khaita03/RANSAC_ROBOT/back_pcb.png

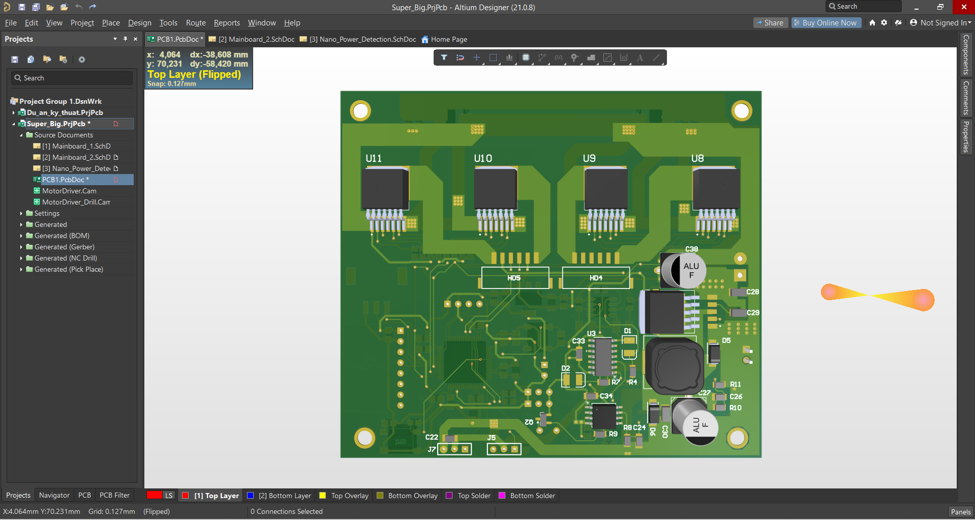
back_pcb.png
