khaita03/RANSAC_ROBOT/config_mcu.jpg

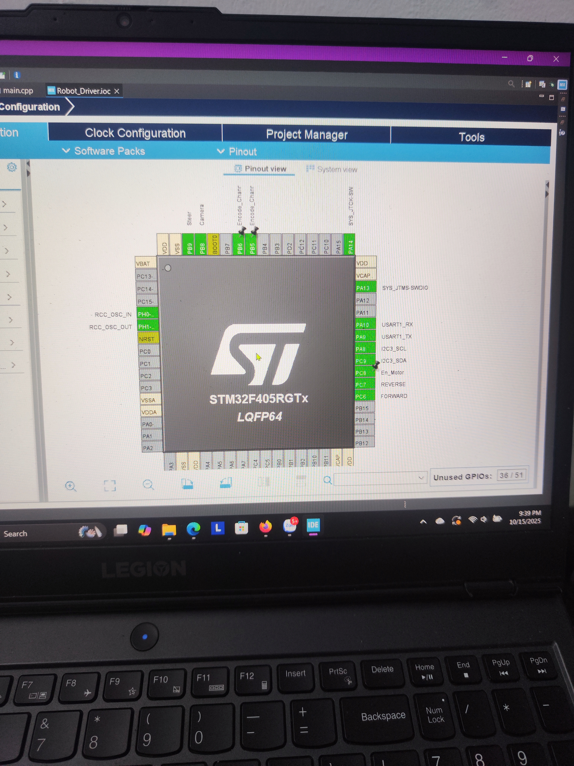
config_mcu.jpg
