khaita03/RANSAC_ROBOT/front_pcb.png

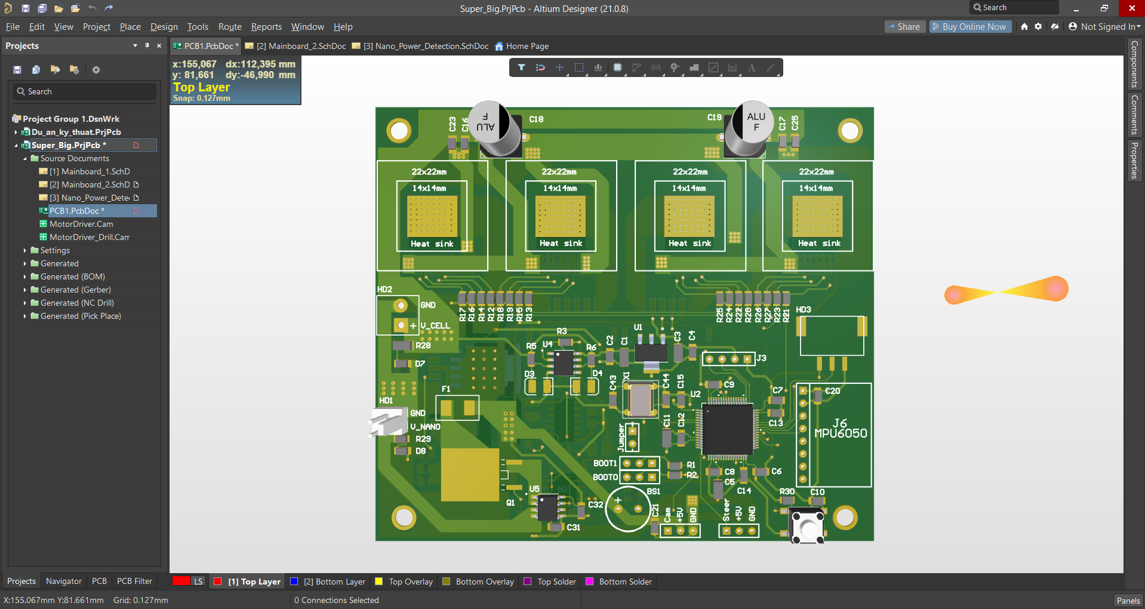
front_pcb.png
