khaita03/RANSAC_ROBOT/mainboard_1 schematic.png

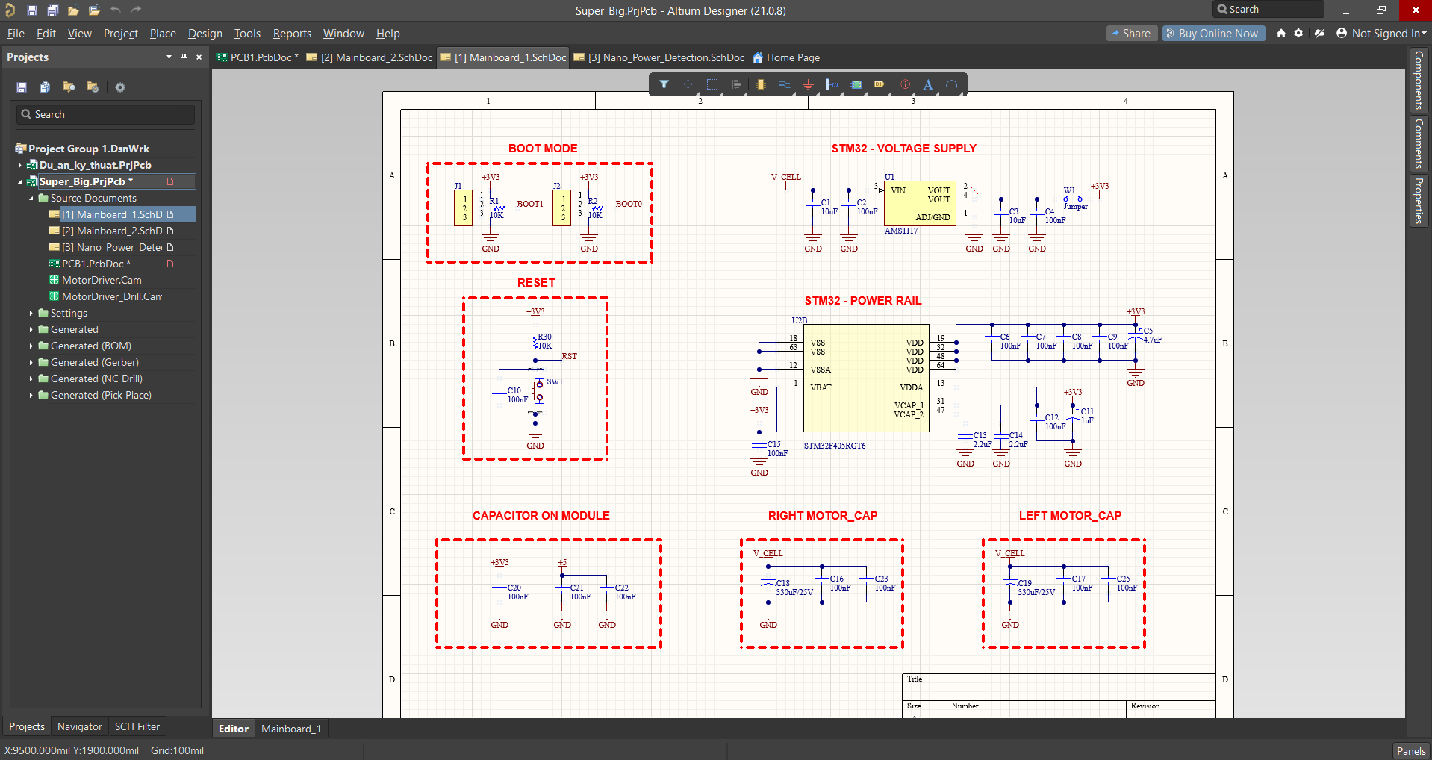
mainboard_1 schematic.png
