khaita03/RANSAC_ROBOT/mainboard_2 schematic.png

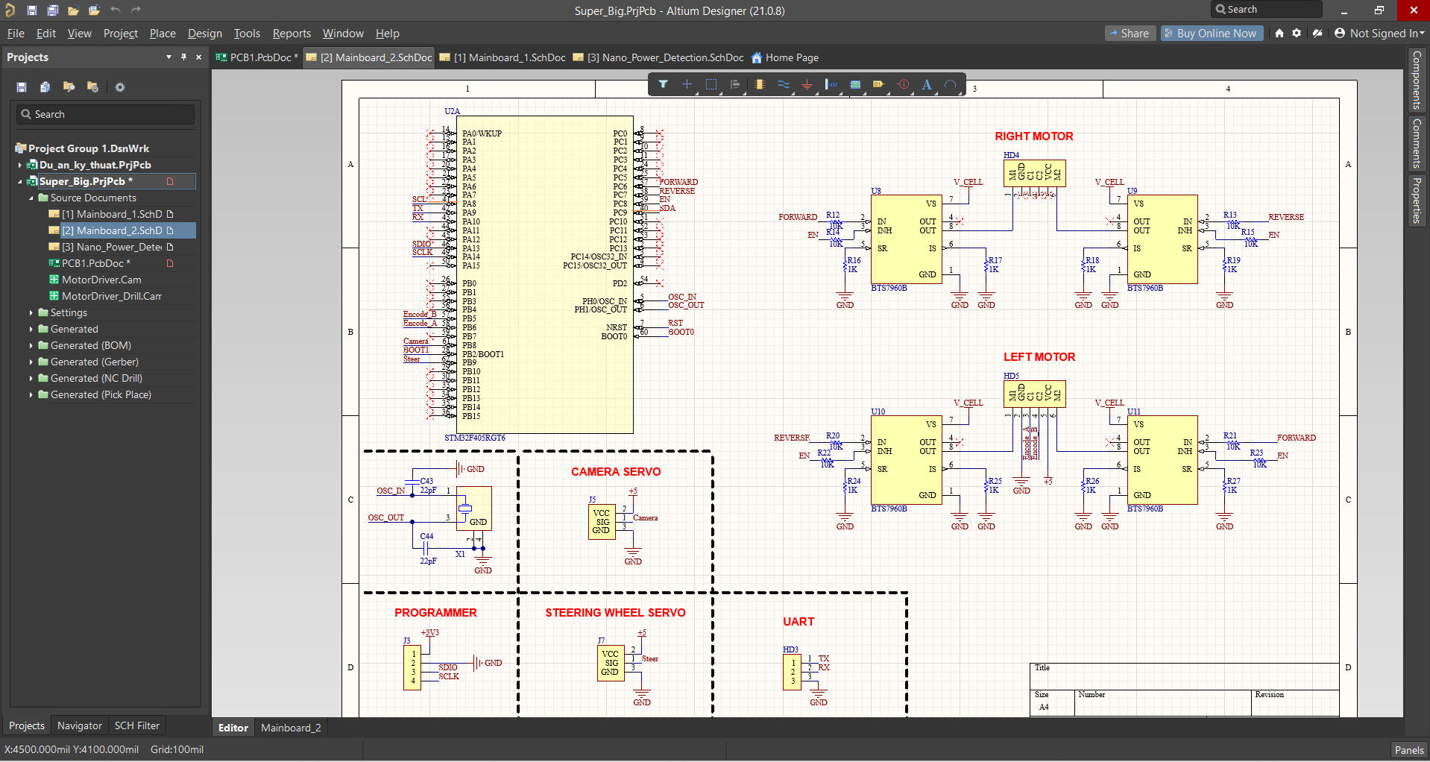
mainboard_2 schematic.png
