khaita03/RANSAC_ROBOT/power_detect schematic.png

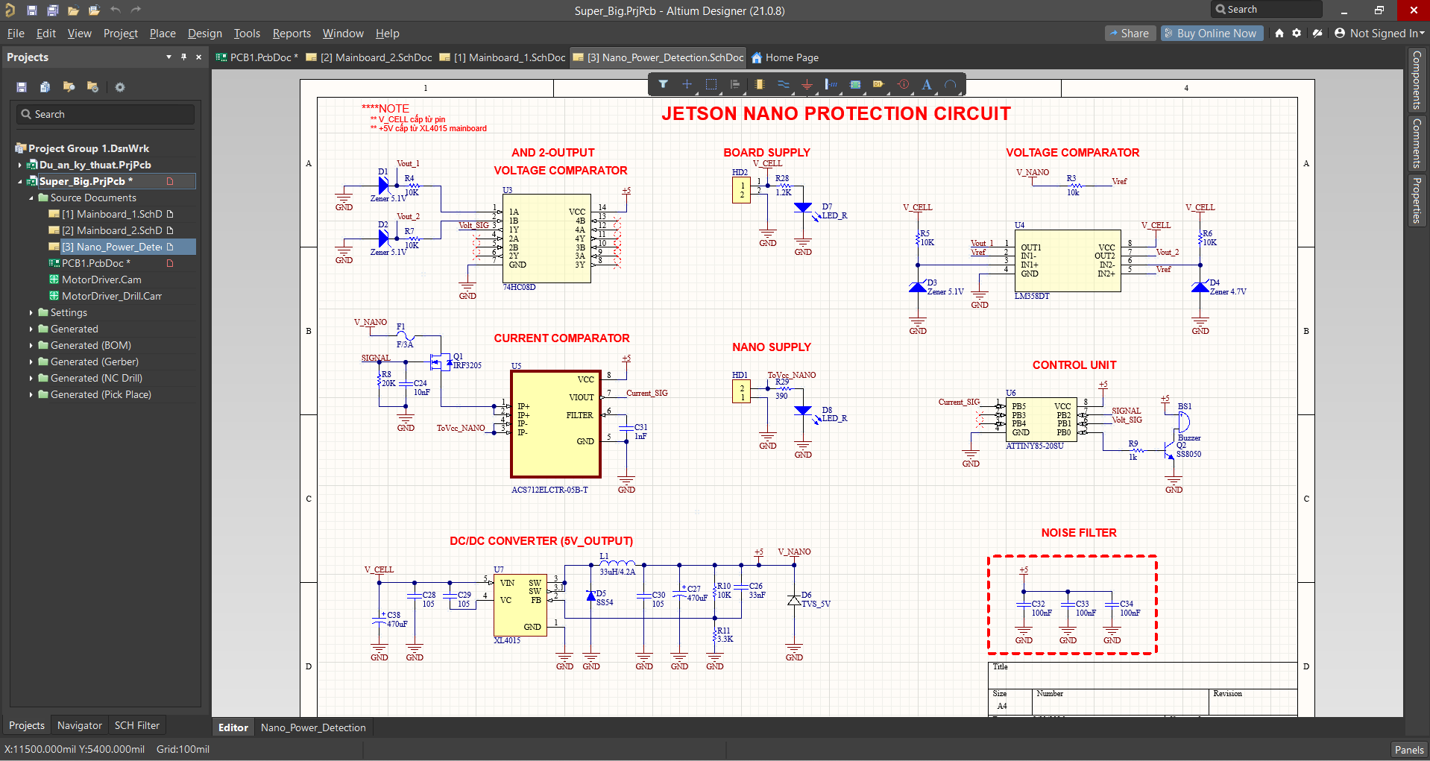
power_detect schematic.png
