khaita03/RANSAC_ROBOT/PCB/Driver/Project Outputs for Super_Big/BOM/Bill of Materials-Super_Big.xlsx

Comment | Description | Designator | Footprint | LibRef | Quantity
1nF | Capacitor | C31 | 6-0805_M | Cap | 1
1uF | Polarized Capacitor (Radial) | C11 | C1206 | Cap Pol1 | 1
1.2K | Resistor | R28 | C1206 | Res1 | 1
2_pin connector |  | HD2 | 2_PIN POWER 3.96 | 2_pin connector | 1
3_pin conn |  | HD3 | 3-pin XHB_2.54 | 3_pin conn | 1
3.3K | Resistor | R11 | 6-0805_N | Res1 | 1
4_pin connector |  | J3 | 4_PIN 2.54mm | 4_pin connector | 1
8_pin IMU Connector |  | J6 | 8_PIN IMU CONNECTOR - duplicate | 8_pin IMU Connector | 1
10nF | Capacitor | C24 | 6-0805_M | Cap | 1
20K | Resistor | R8 | 6-0805_N | Res1 | 1
33nF | Capacitor | C26 | 6-0805_M | Cap | 1
33uH/4.2A | Inductor | L1 | IND_CDRH127/LDNP-470MC_SUM | Inductor | 1
74HC08D |  | U3 | SO14_SOT108-1_NEX | 74HC08D | 1
390 | Resistor | R29 | 6-0805_N | Res1 | 1
ACS712ELCTR-05B-T | Current Sensor 5A 1 Channel Hall Effect, Open Loop Bidirectional 8-SOIC (0.154, 3.90mm Width) | U5 | SOIC127P600X175-8N | ACS712ELCTR-05B-T | 1
AMS1117 | 1A LOW DROPOUT VOLTAGE REGULATOR SOT-223 | U1 | SOT229P700X180-4N | AMS1117 | 1
ATTINY85-20SU |  | U6 | 8S2_ATM | ATTINY85-20SU | 1
Buzzer |  | BS1 | Buzzer | Buzzer | 1
Cap Pol1 | Polarized Capacitor (Radial) | C5 | C1206 | Cap Pol1 | 1
F/3A |  | F1 | FUSE (6.1 x 2.69 x 2.69mm) - duplicate | Fuse | 1
Header2 | Header IDC, 2 x 1 Pin Vertical 2.54mm Pitch (Non-Boxed, Male) | HD1 | HDR2 | Header2 | 1
IRFZ44 |  | Q1 | TO-263 | IRFZ44 | 1
Jumper |  | W1 | Jumper | Jumper | 1
LM358DT |  | U4 | SOIC127P600X175-8N | LM358DT | 1
SS54 | Diode Schottky 40 V 5A Surface Mount DO-214AC (SMA) | D5 | DIOT_M5_025X220N | SS54-HF | 1
SS8050 | NPN General Purpose Amplifier | Q2 | SOT23_M | SS8050 | 1
STM32F405RGT6 | High-performance foundation line, Arm Cortex-M4 core with DSP and FPU, 1 Mbyte of Flash memory, 168 MHz CPU, ART Accelerator | U2 | LQFP64-10x10mm | STM32F405RGT6 | 1
SW | Switch button 4 pin | SW1 | SW2-SMD | SW4 | 1
TVS_5V |  | D6 | DIOT_M5_025X220N | TVS_5V | 1
XL4015 | 5A 180KHz 36V Buck DC to DC Converter | U7 | CONV_XL4015 | XL4015 | 1
XT4 | Crystal, 16 MHz, -30 to 85 degC, 3.2 x 2.5 x 0.9 mm SMD | X1 | XT4-SMD | XT4 | 1
Zener 4.7V | Zener Diode | D4 | 3.5X2.8X1.9 | D Zener | 1
2.2uF | Capacitor | C13, C14 | 6-0805_M | Cap | 2
3_pin connector | Boot using for stm32 | J1, J2 | 3_PIN SERVO CONNECTOR | 3_pin connector | 2
3_pin steering wheel |  | J5, J7 | 3_PIN SERVO CONNECTOR | 3_pin steering wheel | 2
6-pin connnector (Encoder DC motor 2mm) |  | HD4, HD5 | 6_PIN MOTOR | 6-pin connnector (Encoder DC motor 2.54mm) | 2
10uF | Capacitor | C1, C3 | C1206 | Cap | 2
22pF | Capacitor | C43, C44 | 6-0805_M | Cap | 2
330uF/25V | Capacitor (Semiconductor SIM Model) | C18, C19 | CAP-ALU-SMD-F | CN-ALU-DIP | 2
470uF | Polarized Capacitor (Surface Mount) | C27, C38 | CAP-ALU-SMD-F | Cap Pol3 | 2
LED_R | Typical RED GaAs LED | D7, D8 | 6-0805_M | LED1 | 2
105 | Capacitor | C28, C29, C30 | C1206 | Cap | 3
Zener 5.1V | Zener Diode | D1, D2, D3 | 3.5X2.8X1.9 | D Zener | 3
BTS7960B | Half Bridge Driver DC Motors, General Purpose DMOS PG-TO263-7-1 | U8, U9, U10, U11 | DPAK127P1490X440-8N | BTS7960B | 4
1k | Resistor | R9, R16, R17, R18, R19, R24, R25, R26, R27 | 6-0805_N | Res1 | 9
10K | Resistor | R1, R2, R3, R4, R5, R6, R7, R10, R12, R13, R14, R15, R20, R21, R22, R23, R30 | 6-0805_N | Res1 | 17
100nF | Capacitor | C2, C4, C6, C7, C8, C9, C10, C12, C15, C16, C17, C20, C21, C22, C23, C25, C32, C33, C34 | 6-0805_M | Cap | 19
