khaita03/RANSAC_ROBOT/row_test.jpg

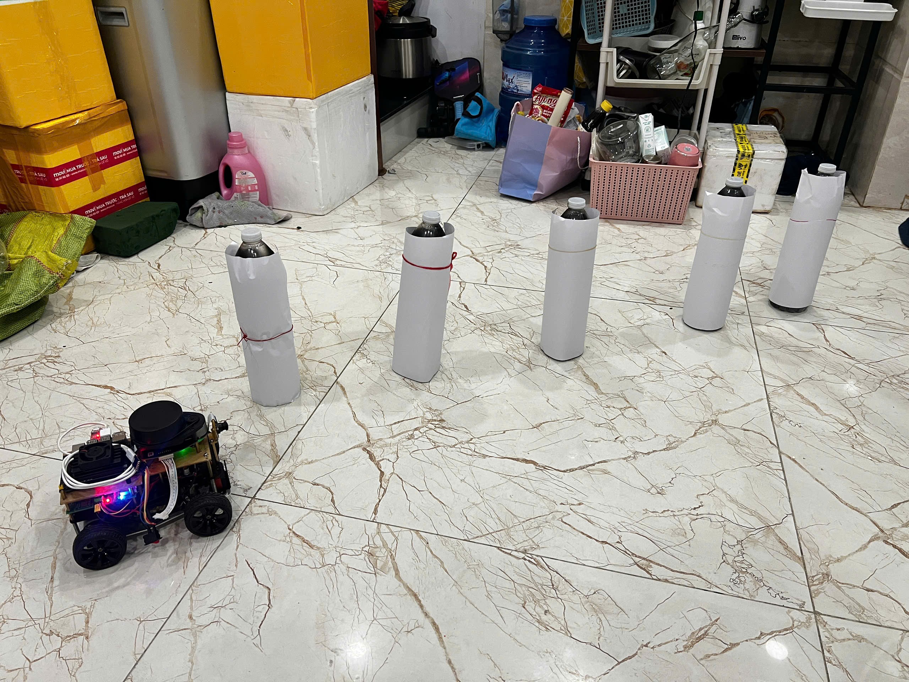
row_test.jpg
