khaita03/RANSAC_ROBOT/PCB/Driver/Mainboard_1.pdf

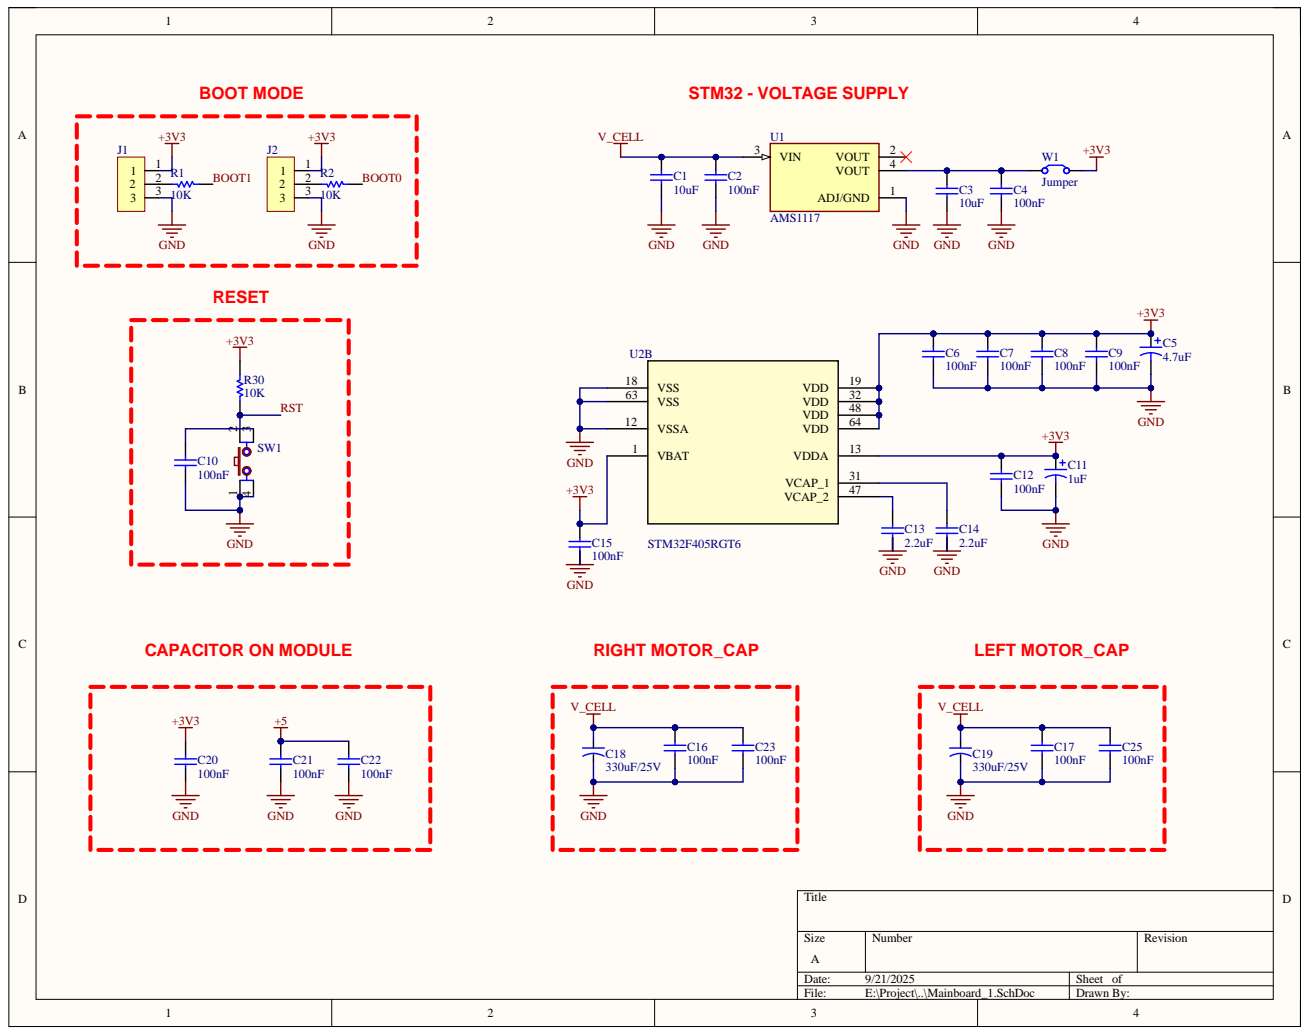
[picture p12: page 1]
