khaita03/RANSAC_ROBOT/PCB/Driver/Mainboard_2.pdf

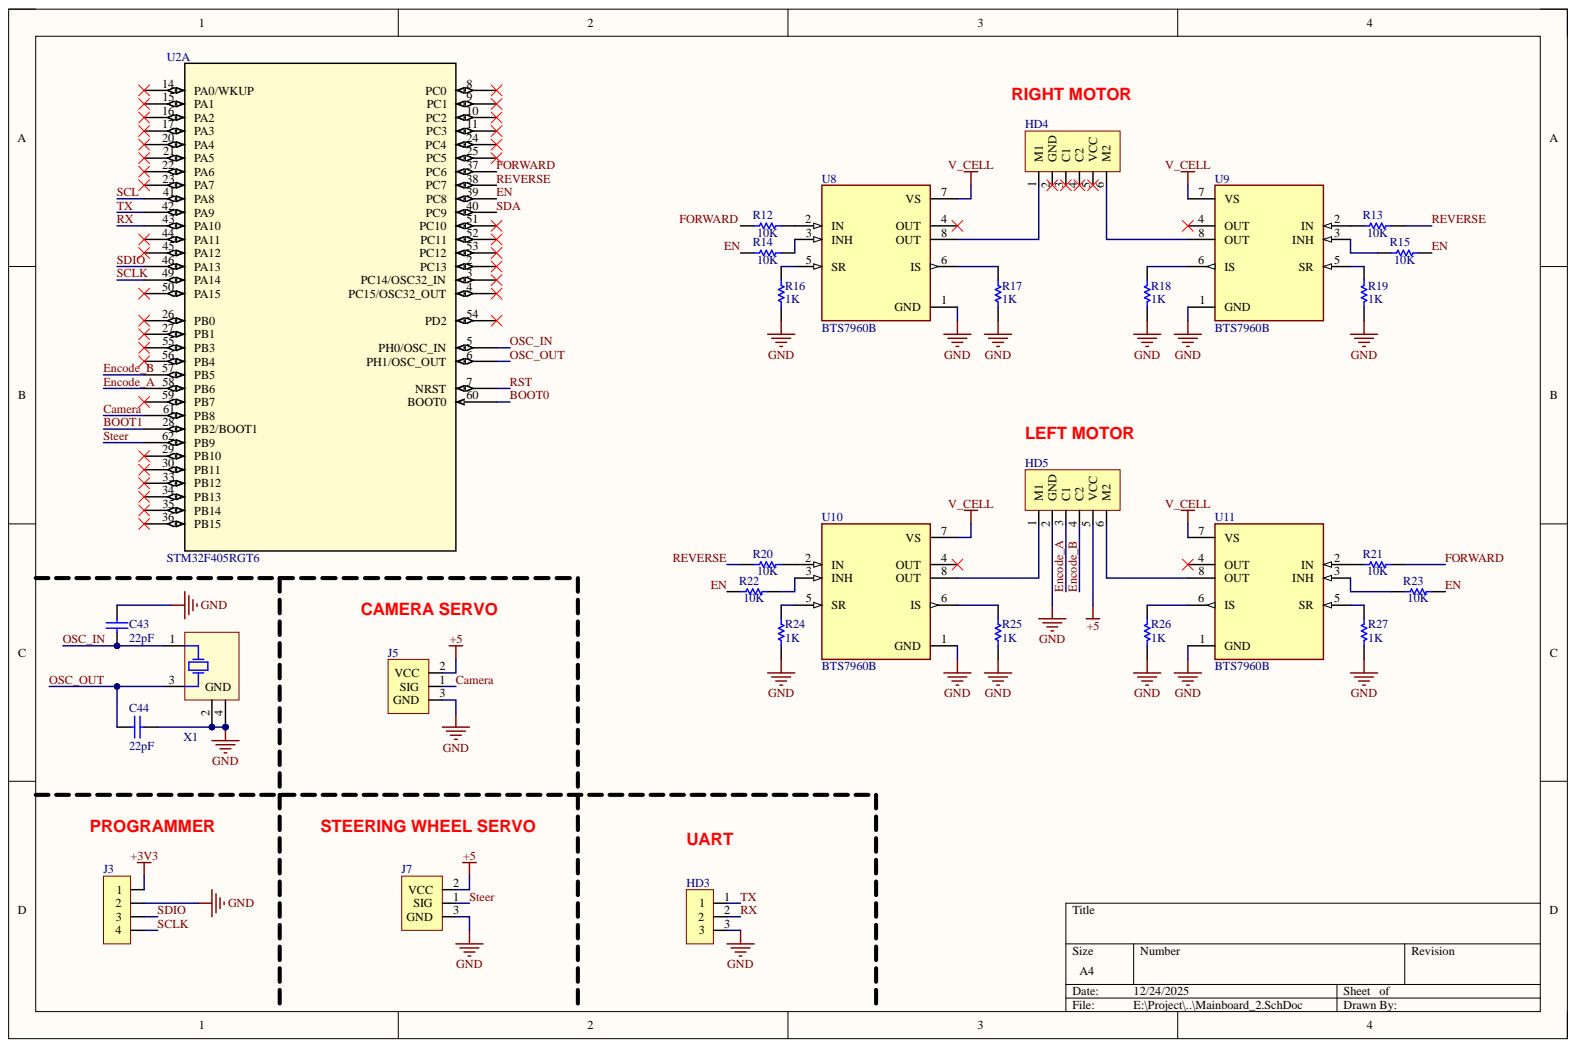
[picture p13: page 1]

Size A4 | Number | Revision

Date: 12/24/2025 | Sheet of
File: E:\Project\..\Mainboard_2.SchDoc | Drawn By:
