khaita03/RANSAC_ROBOT/PCB/Driver/Nano_Power_Detection.pdf

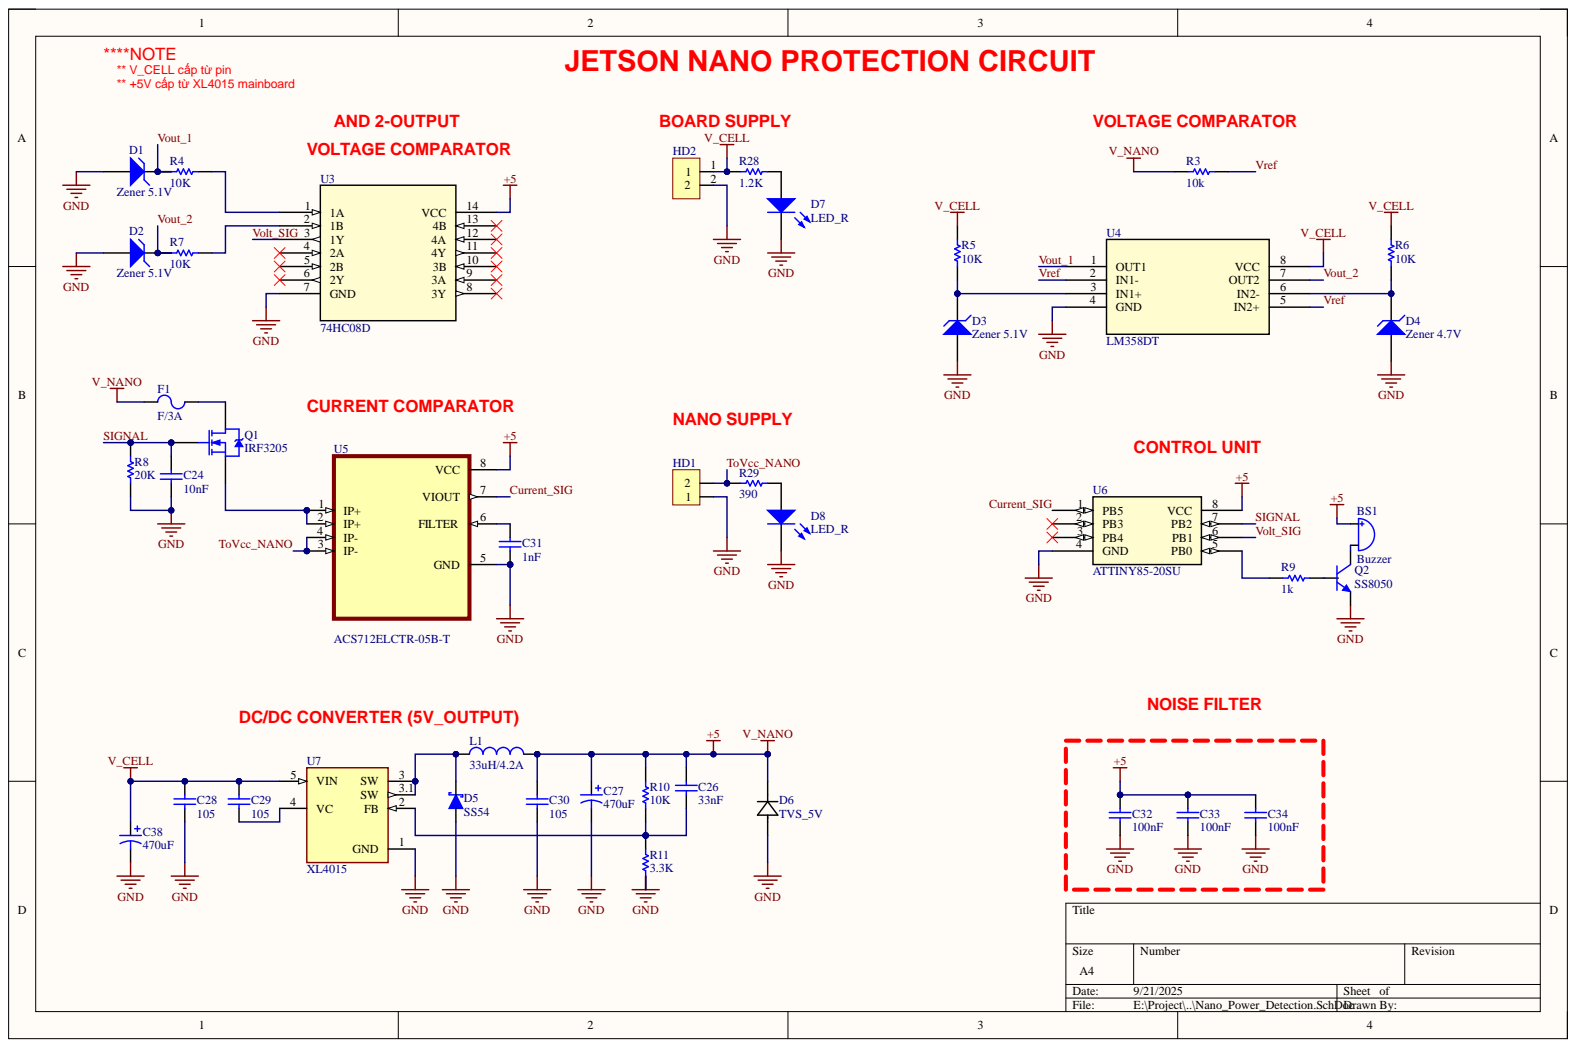
[picture p14: page 1]

1B 2
1Y 3 2A 4 2B 5

Size A4 | Number | Revision

Date: 9/21/2025 | Sheet of
File: E:\Project\..\Nano_Power_Detection.SchDocDrawn By:
