khaita03/RANSAC_ROBOT/(list of files, drawings)

Other design files:
PCB/Driver/Mainboard_1.SchDoc
PCB/Driver/Mainboard_2.SchDoc
PCB/Driver/Nano_Power_Detection.SchDoc
PCB/Driver/PCB1.PcbDoc
PCB/Driver/Super_Big.PrjPcb
