khaita03/RANSAC_ROBOT/Hardware/STM32/Core/Inc/main.h

#define FORWARD_Pin GPIO_PIN_6
#define FORWARD_GPIO_Port GPIOC
#define REVERSE_Pin GPIO_PIN_7
#define REVERSE_GPIO_Port GPIOC
#define EN_Pin GPIO_PIN_8
#define EN_GPIO_Port GPIOC
#define Encoder_A_Pin GPIO_PIN_5
#define Encoder_A_GPIO_Port GPIOB
#define Encoder_A_EXTI_IRQn EXTI9_5_IRQn
#define Encoder_B_Pin GPIO_PIN_6
#define Encoder_B_GPIO_Port GPIOB
#define Encoder_B_EXTI_IRQn EXTI9_5_IRQn
