khaita03/RANSAC_ROBOT/Hardware/STM32/Core/Inc/robot_params.h

#ifndef WHEEL_RADIUS_M
#define WHEEL_RADIUS_M      0.05f      // 5 cm
#endif
#ifndef WHEELBASE_M
#define WHEELBASE_M         0.30f
#endif
#ifndef ENCODER_CPR_X4
#define ENCODER_CPR_X4      2048.0f    // ví dụ
#endif
#ifndef SERVO_MAX_DEG
#define SERVO_MAX_DEG       30.0f
#endif
#ifndef SERVO_US_MIN
#define SERVO_US_MIN        1000
#endif
#ifndef SERVO_US_MAX
#define SERVO_US_MAX        2000
#endif
#ifndef SERVO_US_CENTER
#define SERVO_US_CENTER     1500
#endif
#ifndef MOTOR_V_MAX_MPS
#define MOTOR_V_MAX_MPS     1.0f
#endif
